RyanBooj/CMPE_310_Lab5/Part1_Schematic/Proj_5/parts/LCD4x20.step

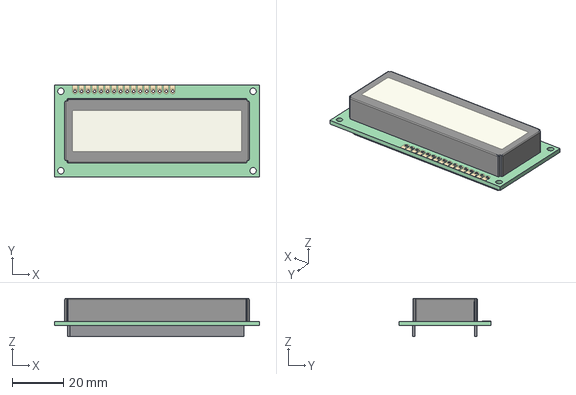
[picture p1: CAD file, 2020-04-16]
Part1_Schematic/Proj_5/parts/LCD4x20.step
80.0 x 36.0 x 15.0 mm
