RyanBooj/CMPE_310_Lab5/Proj_5/Proj_5.kicad_pcb

## KiCad design Proj_5/Proj_5.kicad_pcb (continued)

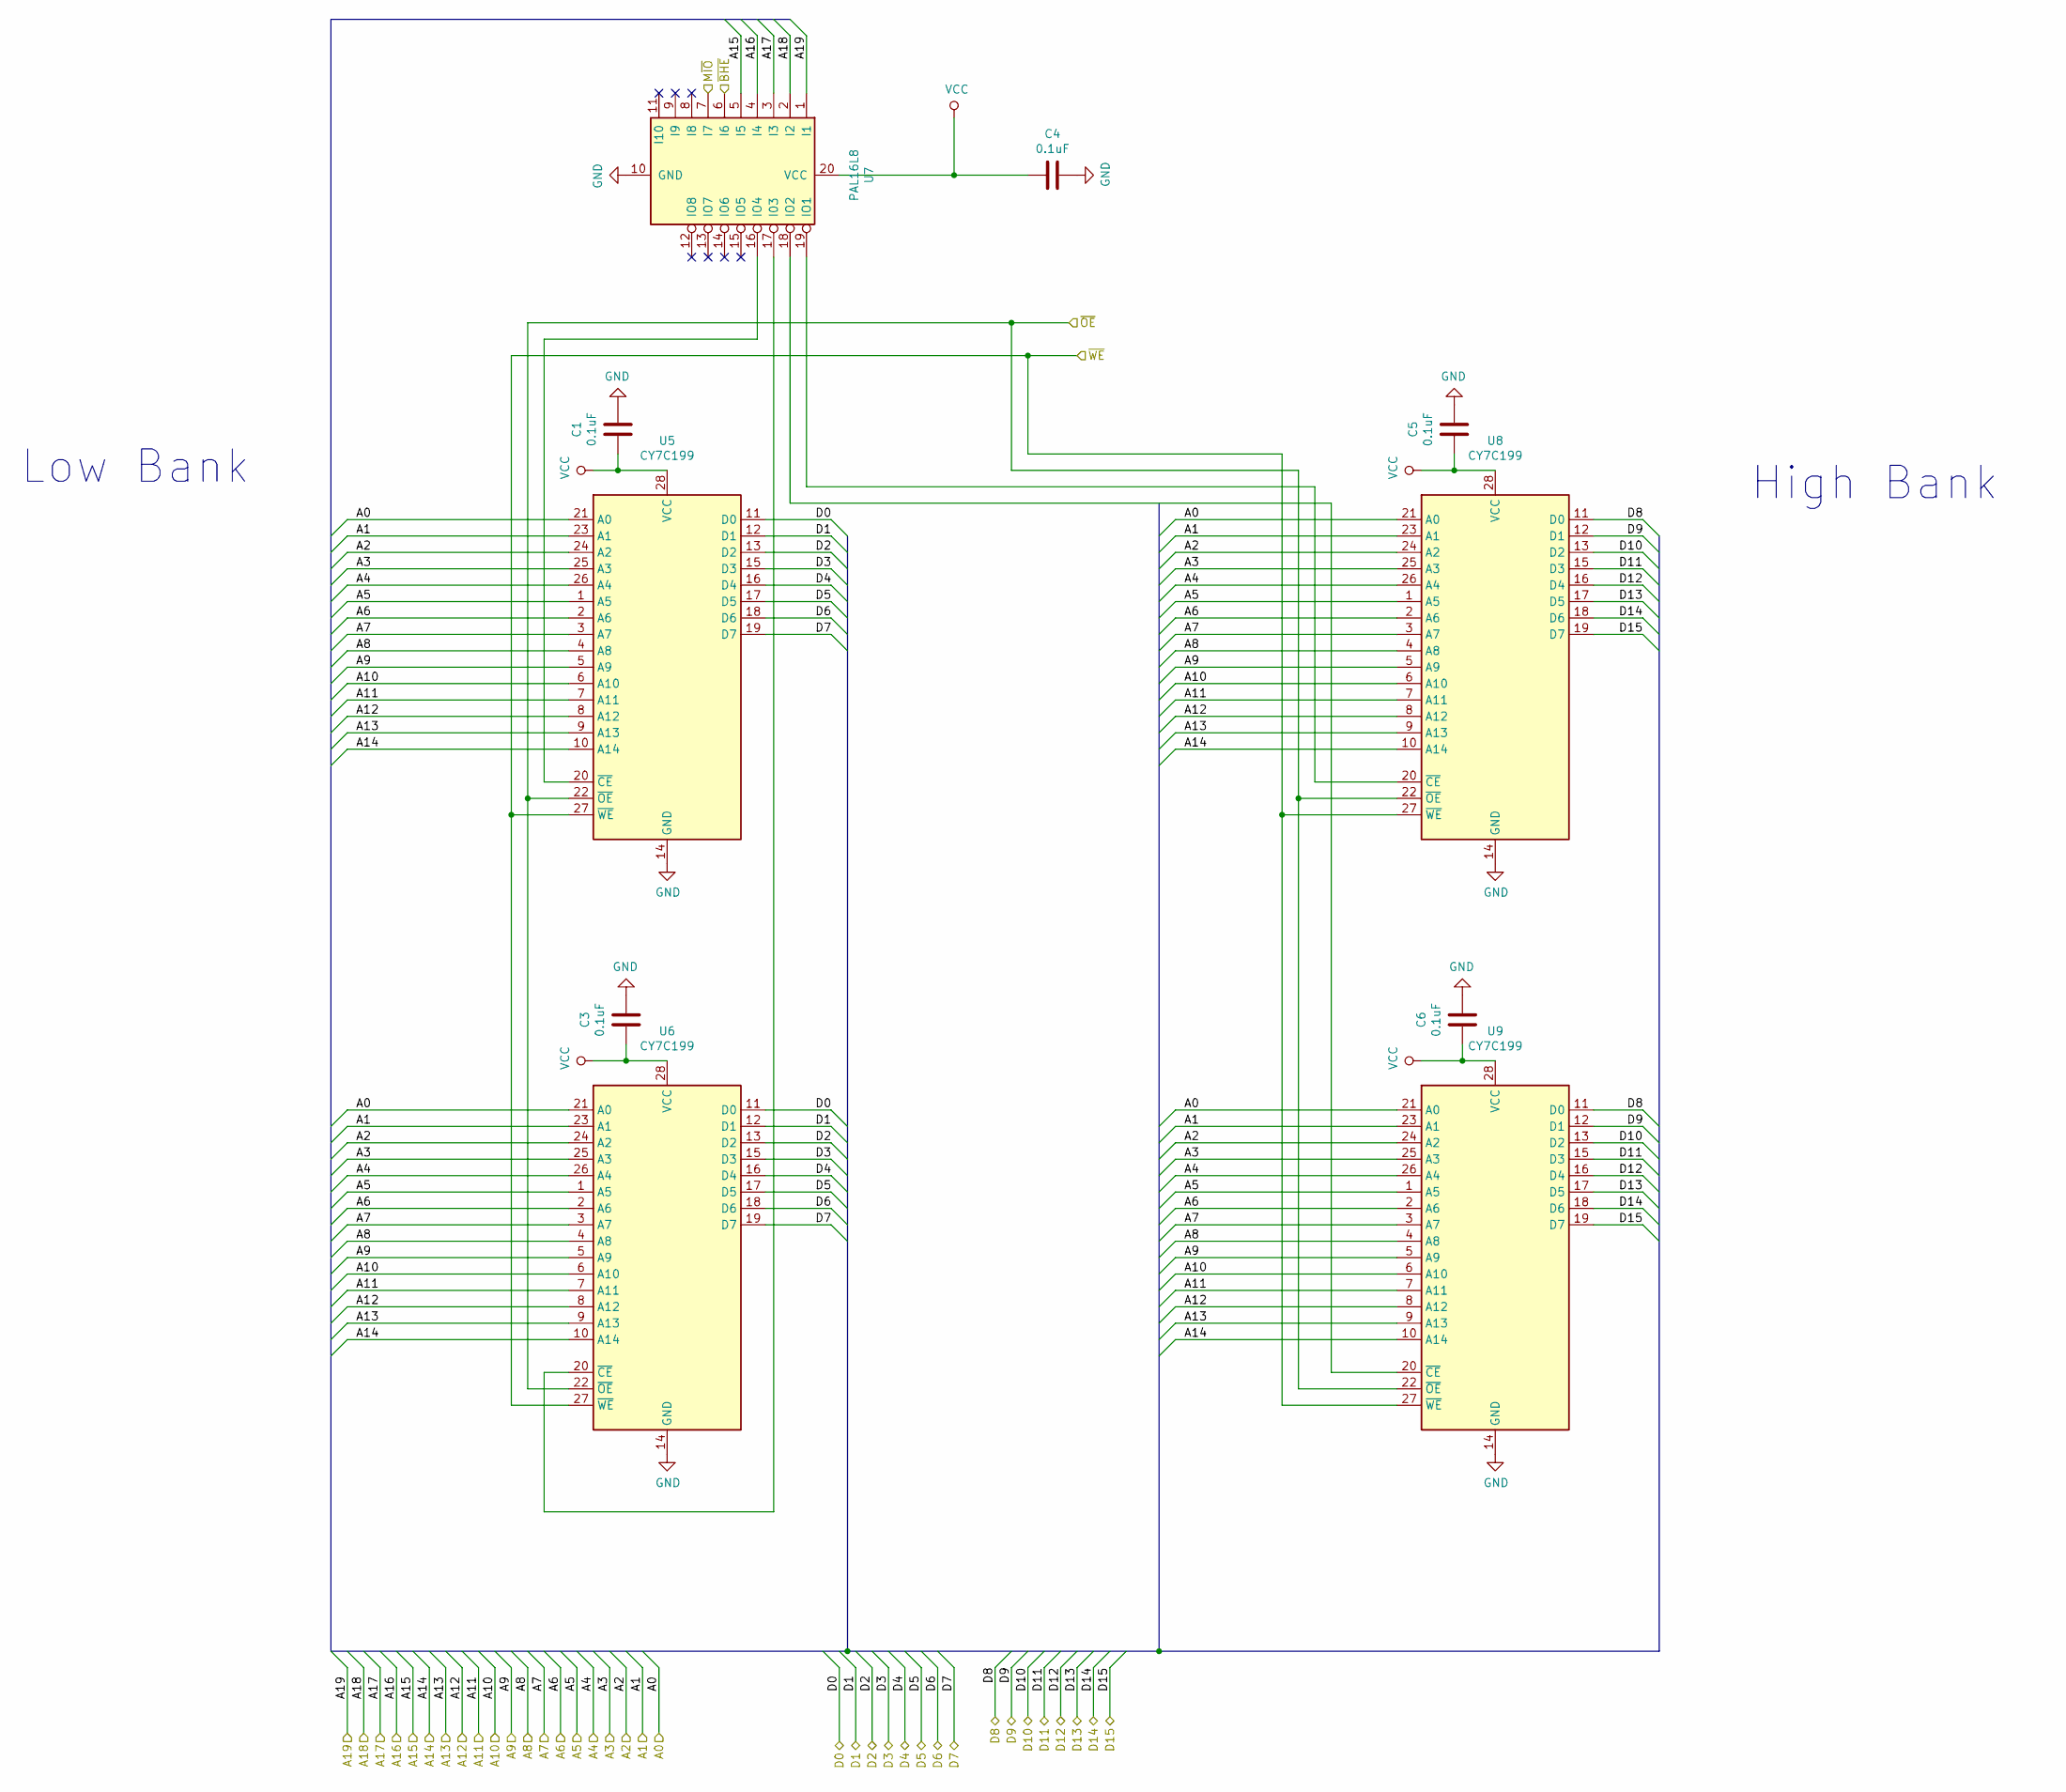
[picture p12: schematic CY7C199.sch]

Parts:
C1, C3, C4, C5, C6: 0.1uF; CP_EIA-1608-08_AVX-J
U5, U6, U8, U9: CY7C199; DIP-28_W15.24mm
U7: PAL16L8; DIP-20_W7.62mm

Connections:
/A0: U5.21 (A0), U6.21 (A0), U8.21 (A0), U9.21 (A0); also elsewhere on the board
/A1: U5.23 (A1), U6.23 (A1), U8.23 (A1), U9.23 (A1); also elsewhere on the board
/A2: U5.24 (A2), U6.24 (A2), U8.24 (A2), U9.24 (A2); also elsewhere on the board
/A3: U5.25 (A3), U6.25 (A3), U8.25 (A3), U9.25 (A3); also elsewhere on the board
/A4: U5.26 (A4), U6.26 (A4), U8.26 (A4), U9.26 (A4); also elsewhere on the board
/A5: U5.1 (A5), U6.1 (A5), U8.1 (A5), U9.1 (A5); also elsewhere on the board
/A6: U5.2 (A6), U6.2 (A6), U8.2 (A6), U9.2 (A6); also elsewhere on the board
/A7: U5.3 (A7), U6.3 (A7), U8.3 (A7), U9.3 (A7); also elsewhere on the board
/A8: U5.4 (A8), U6.4 (A8), U8.4 (A8), U9.4 (A8); also elsewhere on the board
/A9: U5.5 (A9), U6.5 (A9), U8.5 (A9), U9.5 (A9); also elsewhere on the board
/A10: U5.6 (A10), U6.6 (A10), U8.6 (A10), U9.6 (A10); also elsewhere on the board
/A11: U5.7 (A11), U6.7 (A11), U8.7 (A11), U9.7 (A11); also elsewhere on the board
/A12: U5.8 (A12), U6.8 (A12), U8.8 (A12), U9.8 (A12); also elsewhere on the board
/A13: U5.9 (A13), U6.9 (A13), U8.9 (A13), U9.9 (A13); also elsewhere on the board
/A14: U5.10 (A14), U6.10 (A14), U8.10 (A14), U9.10 (A14); also elsewhere on the board
/A15: U7.5 (I5); also elsewhere on the board
/A16: U7.4 (I4); also elsewhere on the board
/A17: U7.3 (I3); also elsewhere on the board
/A18: U7.2 (I2); also elsewhere on the board
/A19: U7.1 (I1); also elsewhere on the board
/D0: U5.11 (D0), U6.11 (D0); also elsewhere on the board
/D1: U5.12 (D1), U6.12 (D1); also elsewhere on the board
/D2: U5.13 (D2), U6.13 (D2); also elsewhere on the board
/D3: U5.15 (D3), U6.15 (D3); also elsewhere on the board
/D4: U5.16 (D4), U6.16 (D4); also elsewhere on the board
/D5: U5.17 (D5), U6.17 (D5); also elsewhere on the board
/D6: U5.18 (D6), U6.18 (D6); also elsewhere on the board
/D7: U5.19 (D7), U6.19 (D7); also elsewhere on the board
/D8: U8.11 (D0), U9.11 (D0); also elsewhere on the board
/D9: U8.12 (D1), U9.12 (D1); also elsewhere on the board
/D10: U8.13 (D2), U9.13 (D2); also elsewhere on the board
/D11: U8.15 (D3), U9.15 (D3); also elsewhere on the board
/D12: U8.16 (D4), U9.16 (D4); also elsewhere on the board
/D13: U8.17 (D5), U9.17 (D5); also elsewhere on the board
/D14: U8.18 (D6), U9.18 (D6); also elsewhere on the board
/D15: U8.19 (D7), U9.19 (D7); also elsewhere on the board
/M~IO: U7.7 (I7); also elsewhere on the board
/~BHE: U7.6 (I6); also elsewhere on the board
/~RD: U5.22 (~OE~), U6.22 (~OE~), U8.22 (~OE~), U9.22 (~OE~); also elsewhere on the board
/~WR: U5.27 (~WE~), U6.27 (~WE~), U8.27 (~WE~), U9.27 (~WE~); also elsewhere on the board
GND: C1.1, C3.1, C4.1, C5.1, C6.1, U5.14 (GND), U6.14 (GND), U7.10 (GND), U8.14 (GND), U9.14 (GND); also elsewhere on the board
unnamed: U5.20 (~CE~), U7.16 (IO4)
unnamed: U6.20 (~CE~), U7.17 (I03)
unnamed: U7.18 (IO2), U9.20 (~CE~)
unnamed: U7.19 (IO1), U8.20 (~CE~)

Notes on the sheet:
Low Bank
High Bank

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
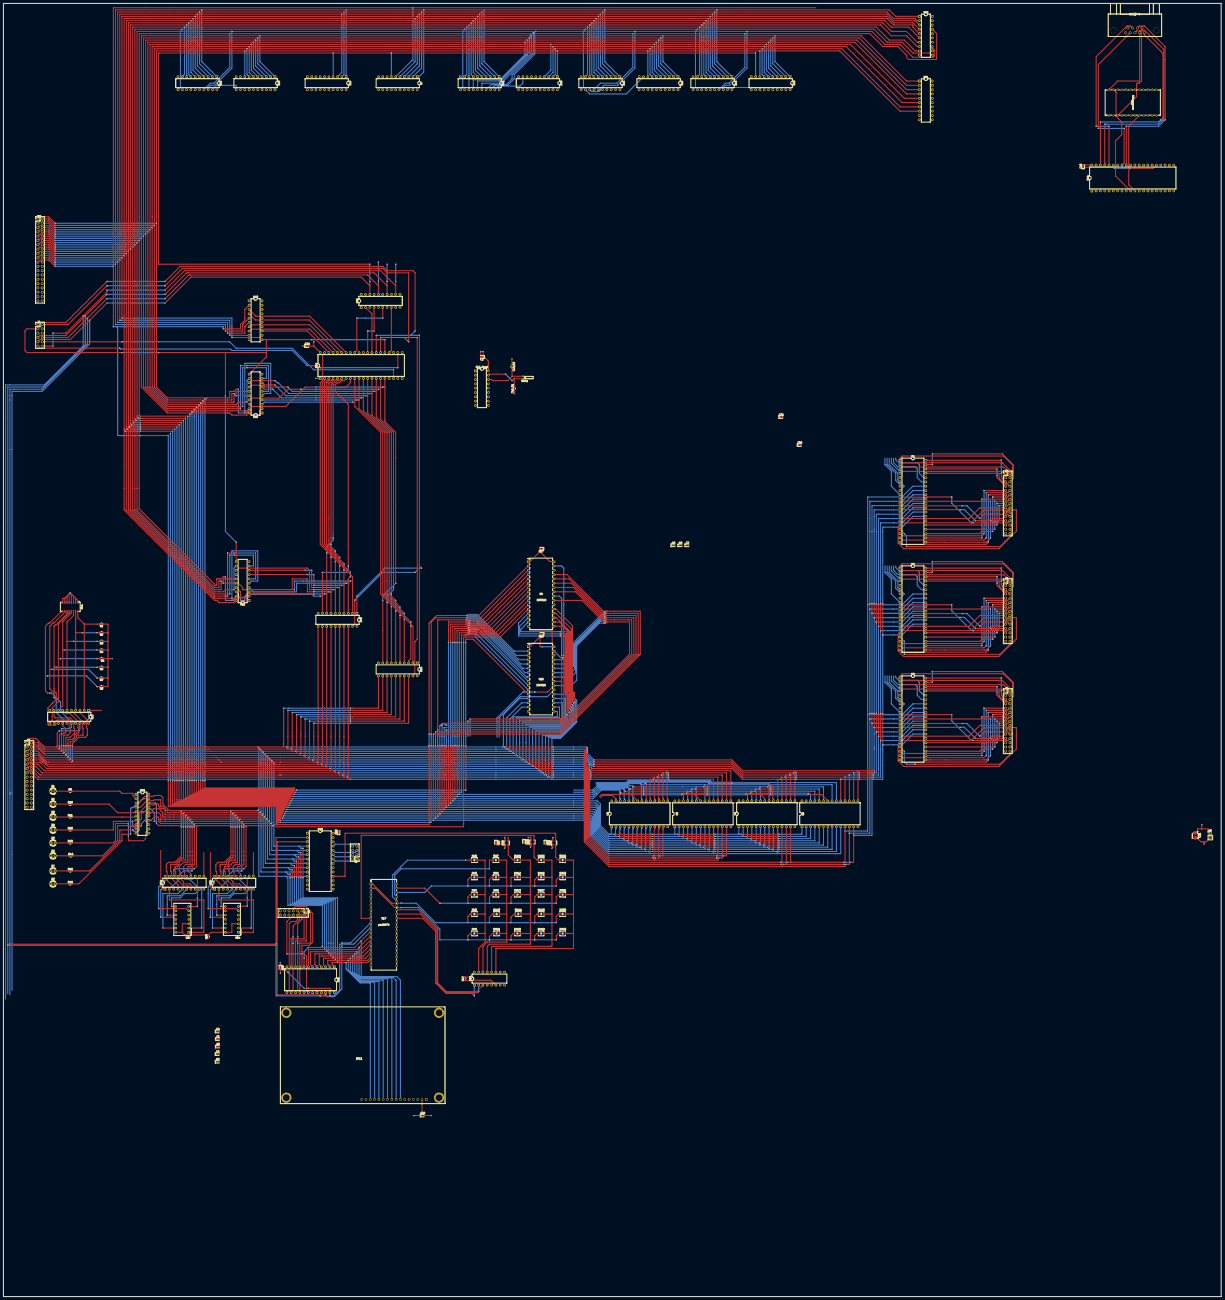
[picture p13: board Proj_5.kicad_pcb from above]

Board: 4 copper layers, 717.5 x 762.0 mm, 132 parts (0 on the bottom side), 264 nets.
