RyanBooj/CMPE_310_Lab5/(commit log)

2020-04-10 Added Project files
    [Proj_5.kicad_pcb, Proj_5.sch]
2020-04-10 Test Changes
    [Proj_5.sch]
2020-04-10 Test Push
    [Proj5_8255s.sch]
2020-04-10 Added 8087 to Proj5 schematic
    [Proj_5.sch]
2020-04-10 Added Address Bus
    [Proj_5.sch]
2020-04-10 Added Power to 8087
    [Proj_5.sch]
2020-04-16 Added missing parts and stuff
    [LCD4x20.step, Proj_5.kicad_pcb]
2020-04-17 Added a clock circuit
    [Clock_Generator.sch, Proj_5.sch]
2020-04-17 Added Schematics, finish SRAM and 8279
    [16550UART.sch, 8254.sch, 8255s.sch, 8259.sch, 8279.sch, CMOS-28F010s.sch, CMOS_Flash.sch, CY7C199.sch]
2020-04-21 Placed 8086 in own Sheet
    [16550UART.sch, 8254.sch, 8255s.sch, 8259.sch, 8279.sch, CMOS-28F010s.sch, CY7C199.sch, Clock_Generator.sch]
2020-04-21 new Sheets
    [8086_Demuxing.sch]
2020-04-22 Buffered and Demultiplexed Address/Data Bus
    [8086_Demuxing.sch]
2020-04-22 Please work
    [8086_Demuxing.sch, CMOS-28F010s.sch]
2020-04-22 Progress on 8279
    [8279.sch, Proj_5.sch]
2020-04-22 Moved Files around in top file, added sheet for display and LEDs
    [16550UART.sch, 8086_Demuxing.sch, 8254.sch, 8255s.sch, 8259.sch, 8279.sch, CMOS-28F010s.sch, CY7C199.sch]
2020-04-22 Labeled Data Bus and Address bus wires in CMOS
    [8279.sch, CMOS-28F010s.sch, Proj_5.sch]
2020-04-22 Added address decoding
    [16550UART.sch, 8086_Demuxing.sch, 8254.sch, 8255s.sch, 8259.sch, 8279.sch, CMOS-28F010s.sch, Display_LEDS.sch]
2020-04-22 Added some connections; Some connections are reporting 'No connections' and IDK why
    [8086_Demuxing.sch, CMOS-28F010s.sch, Proj_5.sch]
2020-04-22 Fixed CMOS and connected to processor. Still missing some pins though
    [8086_Demuxing.sch, CMOS-28F010s.sch, Proj_5.sch]
2020-04-22 Please dont break
    [CMOS-28F010s.sch, CY7C199.sch, Proj_5.sch]
2020-04-22 also no
    [Proj_5.sch]
2020-04-22 Added Caps to Each Vcc per desc.
    [16550UART.sch, 8086_Demuxing.sch, 8254.sch, 8255s.sch, 8259.sch, 8279.sch, CMOS-28F010s.sch, CY7C199.sch]
2020-04-22 Changed Addressing Again
    [CMOS-28F010s.sch, CY7C199.sch, Proj_5.sch]
2020-04-22 Dinner Break
    [CMOS-28F010s.sch, CY7C199.sch, Proj_5.sch]
2020-04-22 Removed 59 and 54 Ind. Sheets, moved to 8279
    [16550UART.sch, 8086_Demuxing.sch, 8255s.sch, 8279_59_54.sch, CMOS-28F010s.sch, CY7C199.sch, Clock_Generator.sch, Display_LEDS.sch]
2020-04-22 Dont be wonky:
    [16550UART.sch, 8086_Demuxing.sch, 8255s.sch, 8279_59_54.sch, CMOS-28F010s.sch, CY7C199.sch, Clock_Generator.sch, Display_LEDS.sch]
2020-04-23 Made a rats nest in 8255.sch
    [8255s.sch, CY7C199.sch]
2020-04-23 Mostly finished 8279
    [8279_59_54.sch]
2020-04-23 Quick Edit to 79 Wires
    [8255s.sch, 8279_59_54.sch, CY7C199.sch, Proj_5.sch]
2020-04-23 Made the rest of the connections for the SRAM. Changed stuff on the main page
    [8279_59_54.sch, CY7C199.sch, Proj_5.sch]
2020-04-23 Sick wires bro
    [8255s.sch, CMOS-28F010s.sch, CY7C199.sch, Proj_5.sch]
2020-04-23 Changes to Top Level Connections
    [8086_Demuxing.sch, 8255s.sch, 8279_59_54.sch, Clock_Generator.sch, Proj_5.sch]
2020-04-23 LCD boop
    [Display_LEDS.sch, Proj_5.sch]
2020-04-23 Rerouted Ext Wires, UART Mostly Complete, All Headers Added
    [16550UART.sch, 8086_Demuxing.sch, 8255s.sch, 8279_59_54.sch, CMOS-28F010s.sch, CY7C199.sch, Display_LEDS.sch, Proj_5.sch]
2020-04-24 Remaining LED Components Added, Final pins added to headers.
    [16550UART.sch, 8086_Demuxing.sch, CY7C199.sch, Display_LEDS.sch, Proj_5.sch]
2020-05-04 Small changes to component placements.
    [Clock_Generator.sch, Proj_5.sch]
2020-05-04 Added Power Flags, finished no connects.
    [16550UART.sch, 8086_Demuxing.sch, 8255s.sch, 8279_59_54.sch, CMOS-28F010s.sch, CY7C199.sch, Clock_Generator.sch, Display_LEDS.sch]
2020-05-04 Finished Most of power flags, power connector header, added hierachical pins to a few sheets.
    [16550UART.sch, 8086_Demuxing.sch, Display_LEDS.sch, LED_Switch.sch, Proj_5.sch]
2020-05-05 Power Flags
    [16550UART.sch, 8086_Demuxing.sch, 8255s.sch, 8279_59_54.sch, CMOS-28F010s.sch, CY7C199.sch, Clock_Generator.sch, Display_LEDS.sch]
2020-05-05 Addressing for 8279 and 8259
    [16550UART.sch, 8086_Demuxing.sch, 8254.sch, 8255s.sch, 8259.sch, 8279.sch, 8279_59_54.sch, CMOS-28F010s.sch]
2020-05-06 Destroyed errors
    [16550UART.sch, 8279_59_54.sch, CMOS-28F010s.sch, CY7C199.sch, LED_Switch.sch, Proj_5.sch]
2020-05-06 11 errors left
    [8086_Demuxing.sch, 8255s.sch, 8279_59_54.sch, CMOS-28F010s.sch, CY7C199.sch, Display_LEDS.sch, LED_Switch.sch, Proj_5.sch]
2020-05-06 1 Error Remains
    [8086_Demuxing.sch, Display_LEDS.sch, LED_Switch.sch, Proj_5.sch]
2020-05-06 Last error destroyed
    [16550UART.sch]
2020-05-06 Added 5 Footprints
    [16550UART.sch, 8279_59_54.sch, CMOS-28F010s.sch, Display_LEDS.sch, Proj_5.sch]
2020-05-08 Added at least 4 Footprints
    [16550UART.sch, 8086_Demuxing.sch, 8255s.sch, 8279_59_54.sch, CMOS-28F010s.sch, CY7C199.sch, Clock_Generator.sch, Display.sch]
2020-05-08 No more and gates
    [8255s.sch]
2020-05-08 No more gates 2
    [Display.sch]
2020-05-08 Playing with PCB placements
    [8279_59_54.sch, Display.sch, Proj_5.kicad_pcb]
2020-05-08 Hey Collin
    [8279_59_54.sch, Proj_5.kicad_pcb]
2020-05-08 Cool stuff
    [8279_59_54.sch, CMOS-28F010s.sch, Proj_5.kicad_pcb]
2020-05-09 Bus time
    [Proj_5.kicad_pcb]
2020-05-09 Keyboard + Individual LEDS
    [Proj_5.kicad_pcb]
2020-05-09 Complete Data Bus
    [Proj_5.kicad_pcb]
2020-05-09 Addresses 8-15
    [Proj_5.kicad_pcb]
2020-05-09 Data Aquired
    [CY7C199.sch, Proj_5.kicad_pcb, Proj_5.sch]
2020-05-09 Fixed 'Pad too close to Pad' Errors
    [16550UART.sch, 8086_Demuxing.sch, 8255s.sch, 8279_59_54.sch, CY7C199.sch, Clock_Generator.sch, LED_Switch.sch, Proj_5.kicad_pcb]
2020-05-10 Finished Address Bus + Address and Data Bus Enables
    [Proj_5.kicad_pcb]
2020-05-10 More Headers - 690 to 540 No-Connects
    [8279_59_54.sch, Proj_5.kicad_pcb]
2020-05-10 Fixed 8255 Headers + Control Bus Header
    [Proj_5.kicad_pcb]
2020-05-10 UART Connections + Some other Stuff
    [Proj_5.kicad_pcb]
2020-05-10 Pals Hooked up to Address Bus
    [Proj_5.kicad_pcb]
2020-05-10 Cool pt2
    [LED_Switch.sch, Proj_5.kicad_pcb]
2020-05-10 addresses baby
    [Proj_5.kicad_pcb]
2020-05-11 Wires are Hell
    [CY7C199.sch, LED_Switch.sch, Proj_5.sch]
2020-05-11 Oh lawd he comin
    [8255s.sch, CMOS-28F010s.sch, Proj_5.sch]
